artgomad/wheelchair-design-platform/README.md

# YOGI.SENSE

_**A connected wheelchair to enable wheelchair users to exercise through a yoga guided session.**_

## Concept description

Sitting in a wheelchair during long periods might increase problems of posture, blood circulation, and stiffness in the users’ body. There are so many reasons why yoga can be considered as a therapy for this kind of users, not to mention that it brings together mind and body, increasing well being in general. With this concept, posture is improved through different exercises which can also be considered as healing to joints and muscles avoiding stiffness and increasing blood circulation for wheelchair users. Furthermore, it must be noted that this practice link exercises with respiration, which will not just increase flexibility but also lung capacity.

> This connected wheelchair guides the user through different yoga postures using nine FSR distributed along the seat and backrest; they sense the position of the user, this data is collected making possible a recognition of the different postures the user performs. This way the user will be provided by feedback depending on the prediction made by machine learning.

## Table of contents

* [System architecture](/wheelchair3/docs/System_Architecture.md)
* [Working principle](/wheelchair3/docs/Flow_of_Interaction.md)
* [Step by step instructions. Setting up hardware and libraries](/wheelchair3/docs/Step_by_step_Instructions.md)
* [Exhibition pictures](/wheelchair3/docs/Exhibition_pictures.md)
* [Workshops and projects from other groups](/wheelchair3/docs/Workshops_and_Other_Projects.md)

#### Code running in each device

* [Arduino Mega: Get FSR input and sent through the Serial port](/wheelchair3/docs/1_Mega_Code_Documentation.md)
* [Raspberry Pi: Predict yoga posture and send it through Bluetooth](/wheelchair3/docs/4_Pi_Code_Documentation.md)
* [Adafruit Feather: Read posture through Bluetooth and actuate](/wheelchair3/docs/5_Feather_Code_Documentation.md)

#### Machine learning code

* [Collect and label](/wheelchair3/docs/2_Collect_and_label_Documentation.md)
* [Train and test](/wheelchair3/docs/3_Train_and_test_Documentation.md)

---

## Poster and video

To see a more detailed explanation of the location of the sensors and actuators, we provide you with a video and a poster.

To see the video click [here.](https://youtu.be/LGbsHrdyxcA)

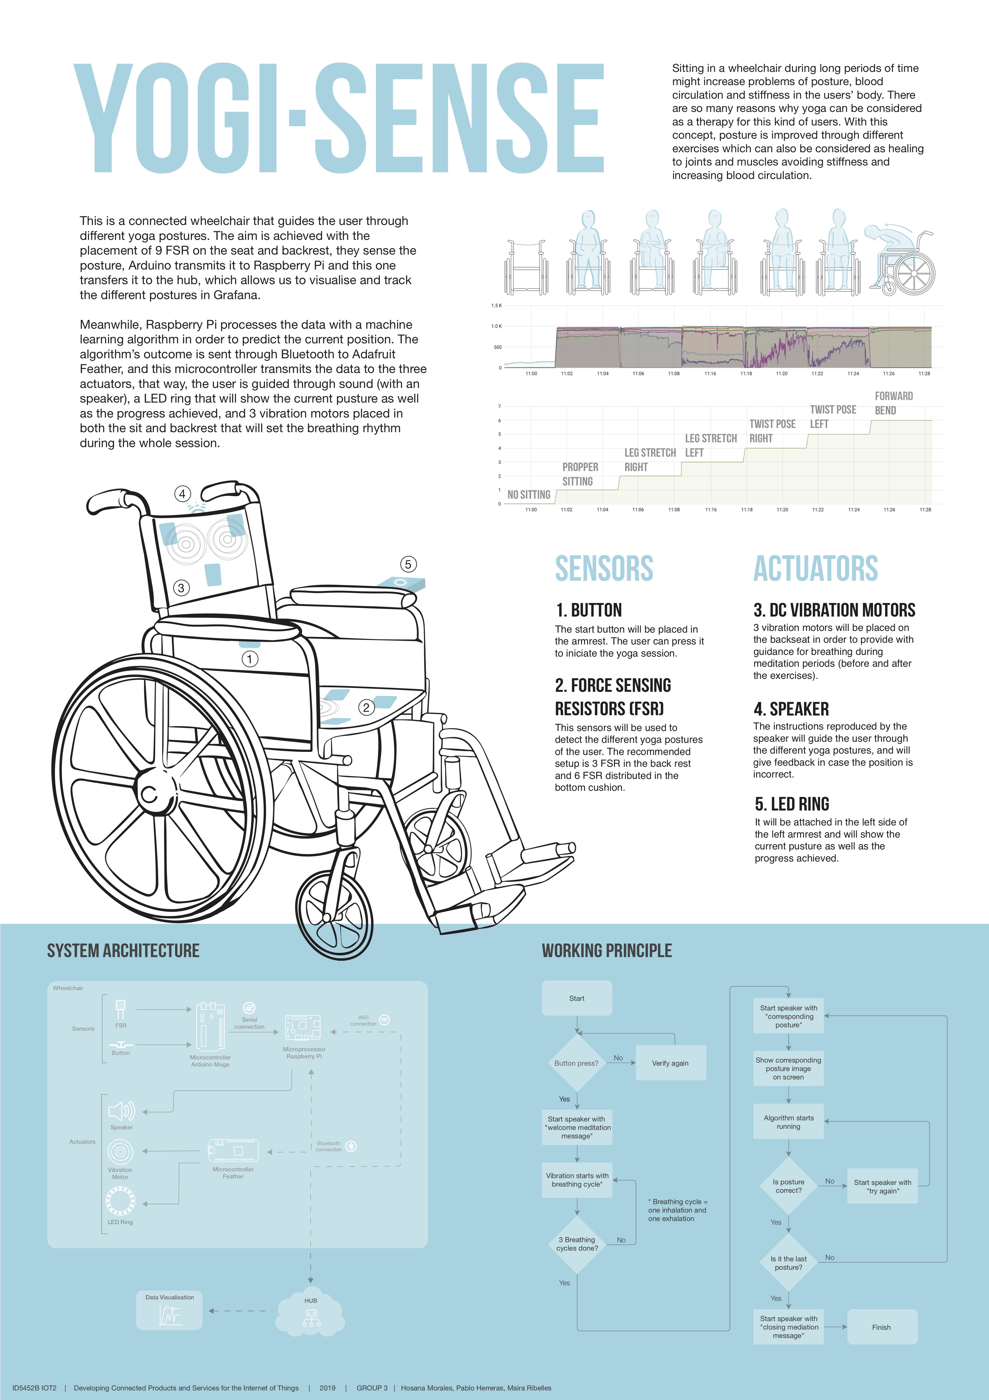
[picture p1: wheelchair3/docs/images/posterfinal.jpg]
Working Principle
