artgomad/wheelchair-design-platform/wheelchair3/docs/Exhibition_pictures.md

## Exhibition pictures

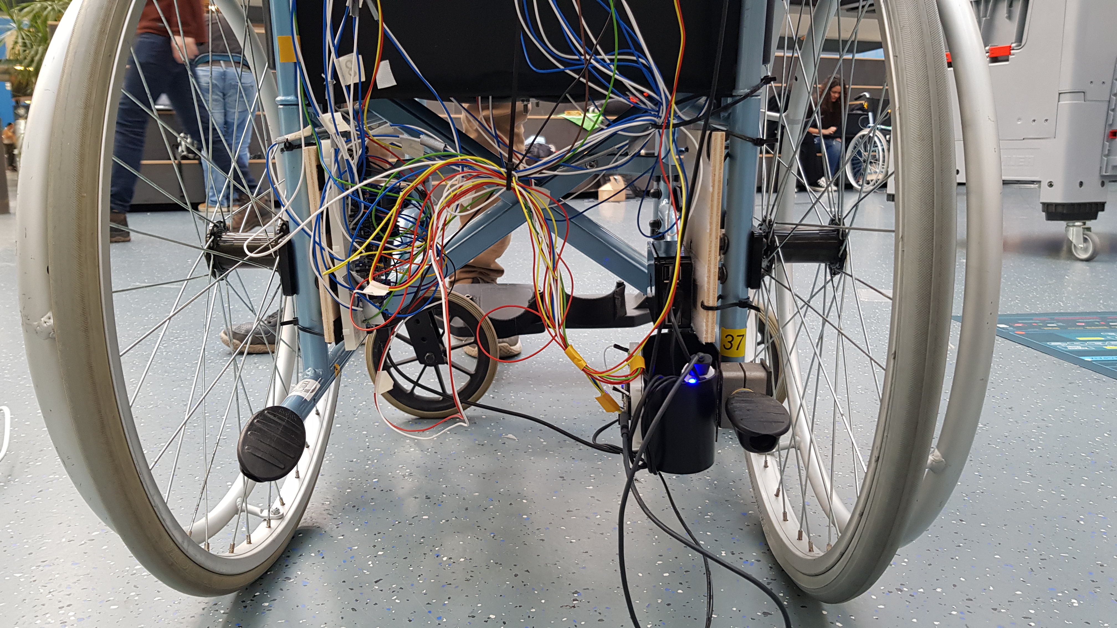
[picture p7: wheelchair3/docs/images/20190408_095746.jpg]


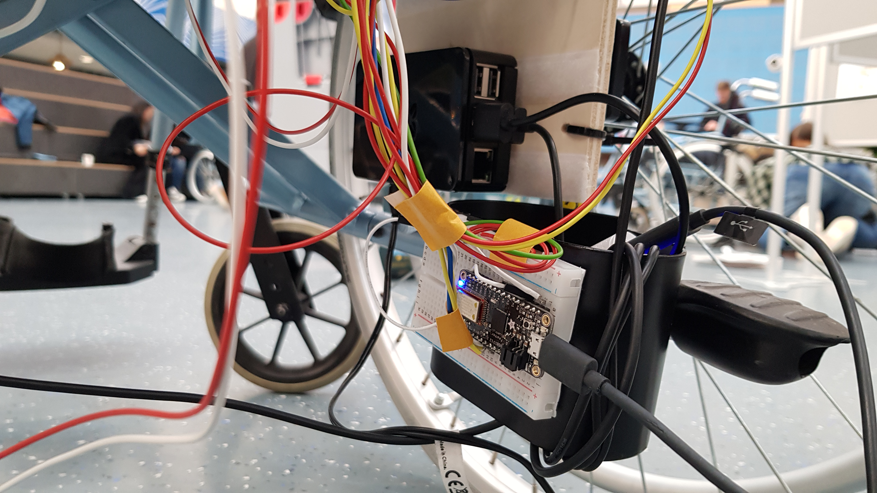
[picture p8: wheelchair3/docs/images/20190408_095825.jpg]


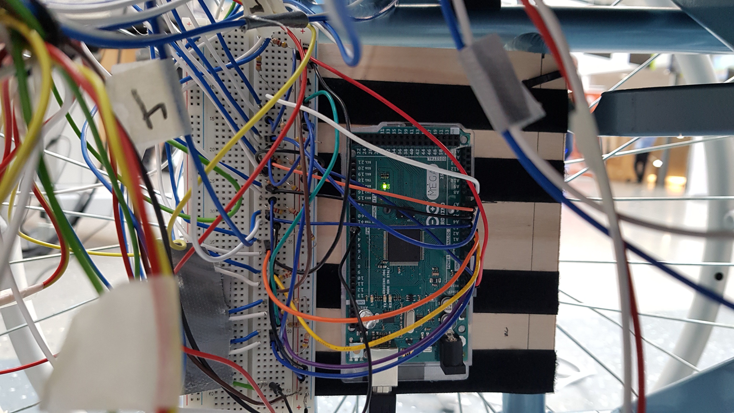
[picture p9: wheelchair3/docs/images/20190408_095846.jpg]


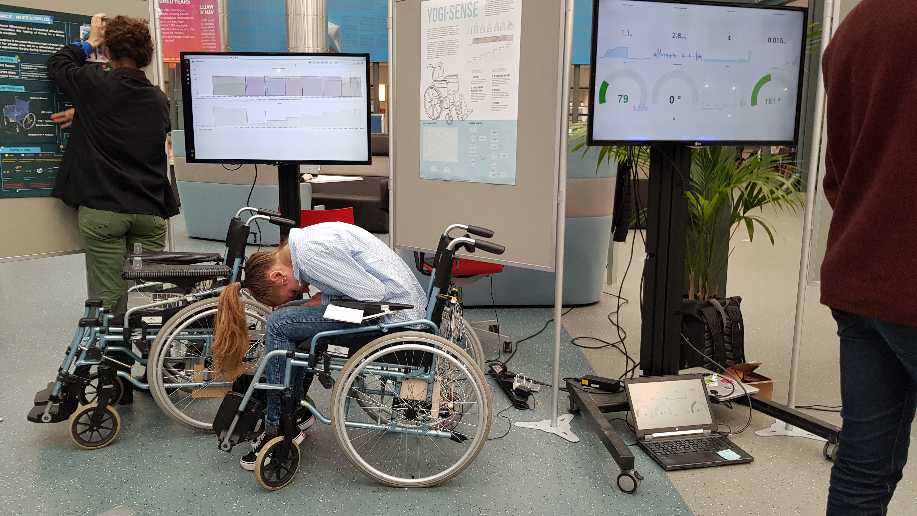
[picture p10: wheelchair3/docs/images/20190408_105127.jpg]


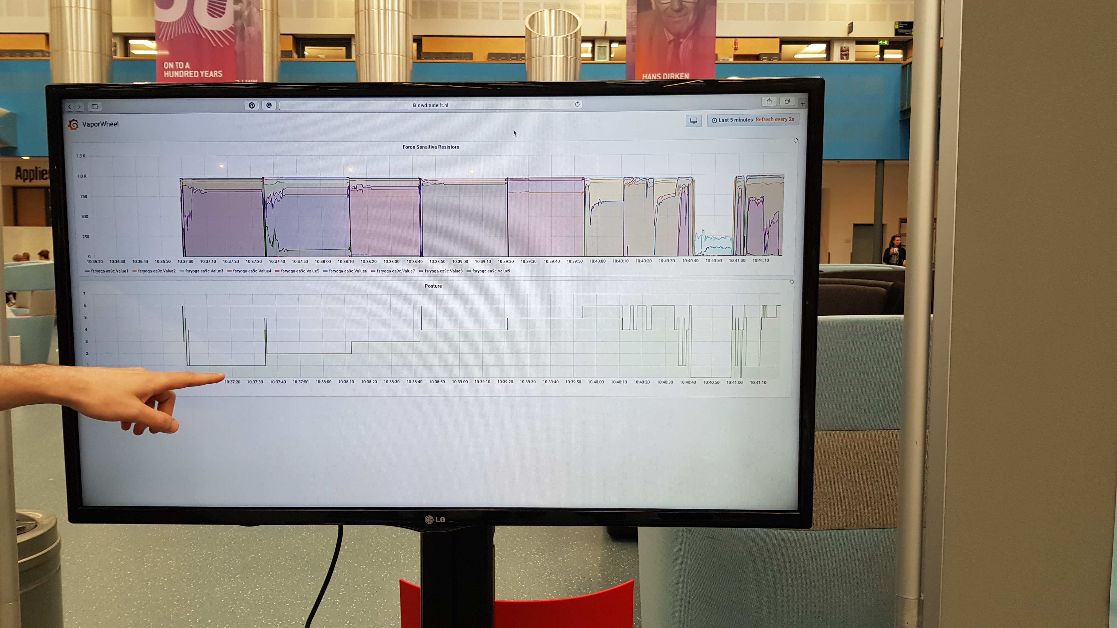
[picture p11: wheelchair3/docs/images/20190408_105216.jpg]


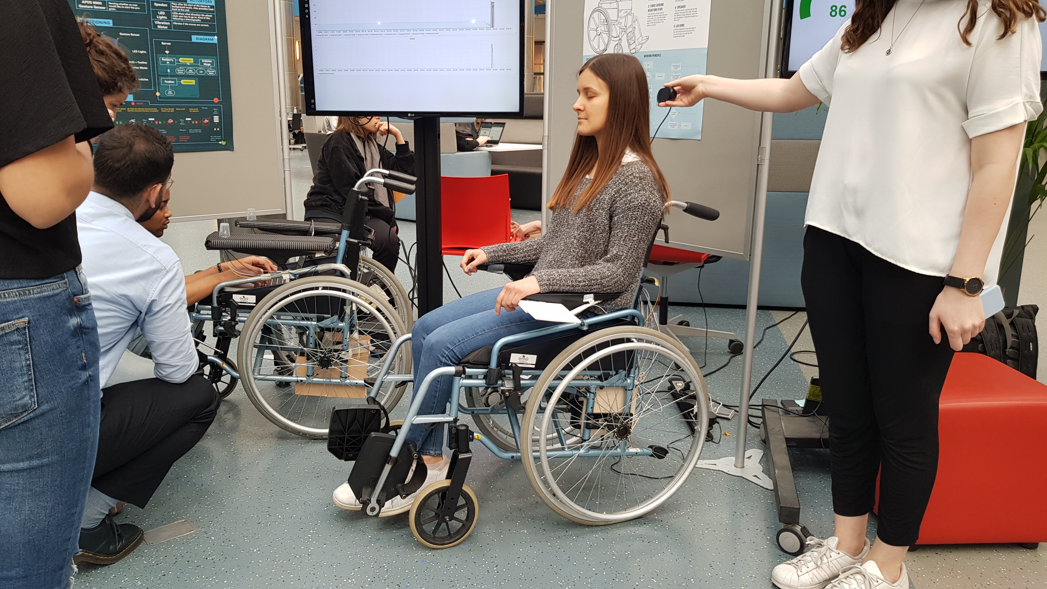
[picture p12: wheelchair3/docs/images/20190408_110552.jpg]


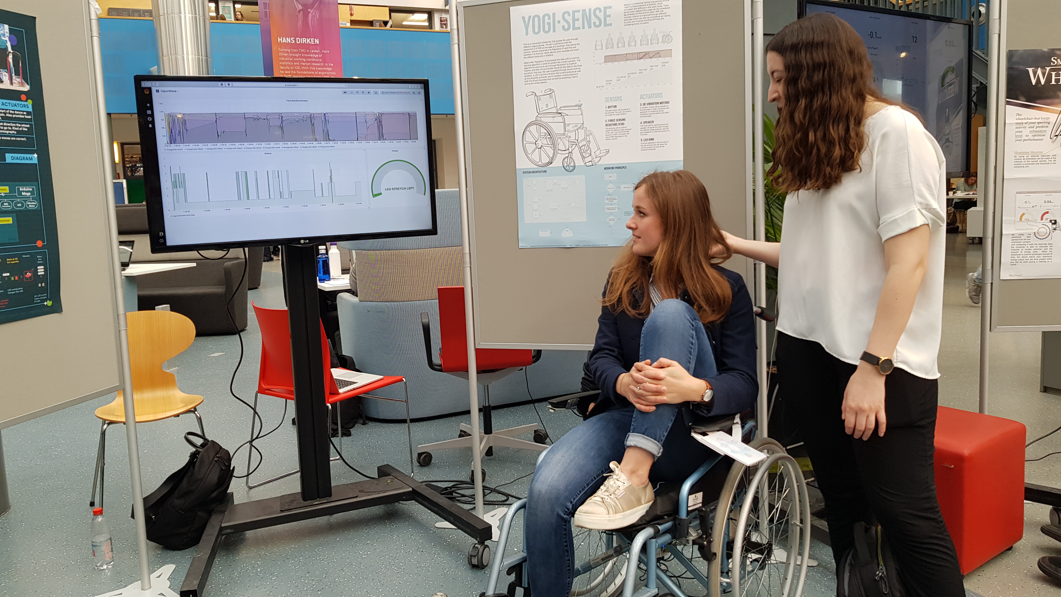
[picture p13: wheelchair3/docs/images/20190408_111807.jpg]
