artgomad/wheelchair-design-platform/(commit log)

2019-03-25 Correction in the ser
    [1_collect_and_label.py]
2019-03-25 Printing sample number
2019-03-25 Yoga wheelchair name
2019-03-29 Last update of the arduino codes
2019-04-01 print edit
2019-04-01 Change max samples to supper quick
2019-04-01 printing the lenght
2019-04-01 update the time frame
2019-04-01 Increased time frame
2019-04-01 print result
2019-04-01 arduino code for display
2019-04-03 little print
2019-04-03 printing values and button value
2019-04-03 Trying to listen audio without prints
2019-04-08 send button value through bluetooth
2019-04-12 Change readme inside wheelchair3
2019-04-15 Highlighting the code frames
